harukiti82/esp32-line-tracer/setting.png

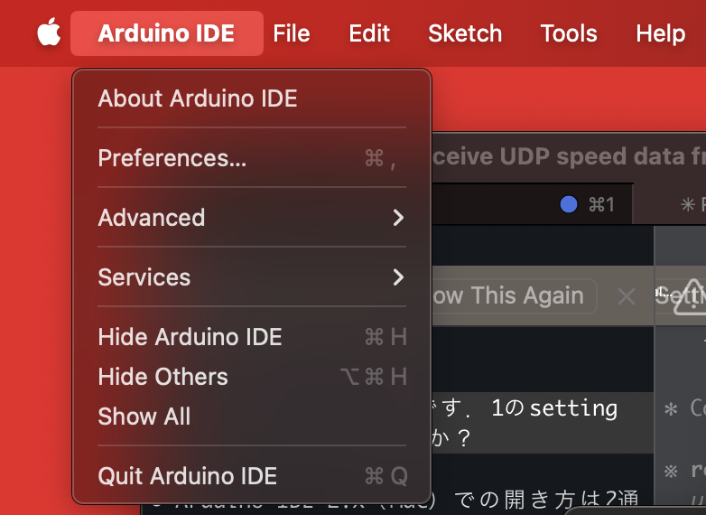
setting.png
