harukiti82/esp32-line-tracer/setting1.png

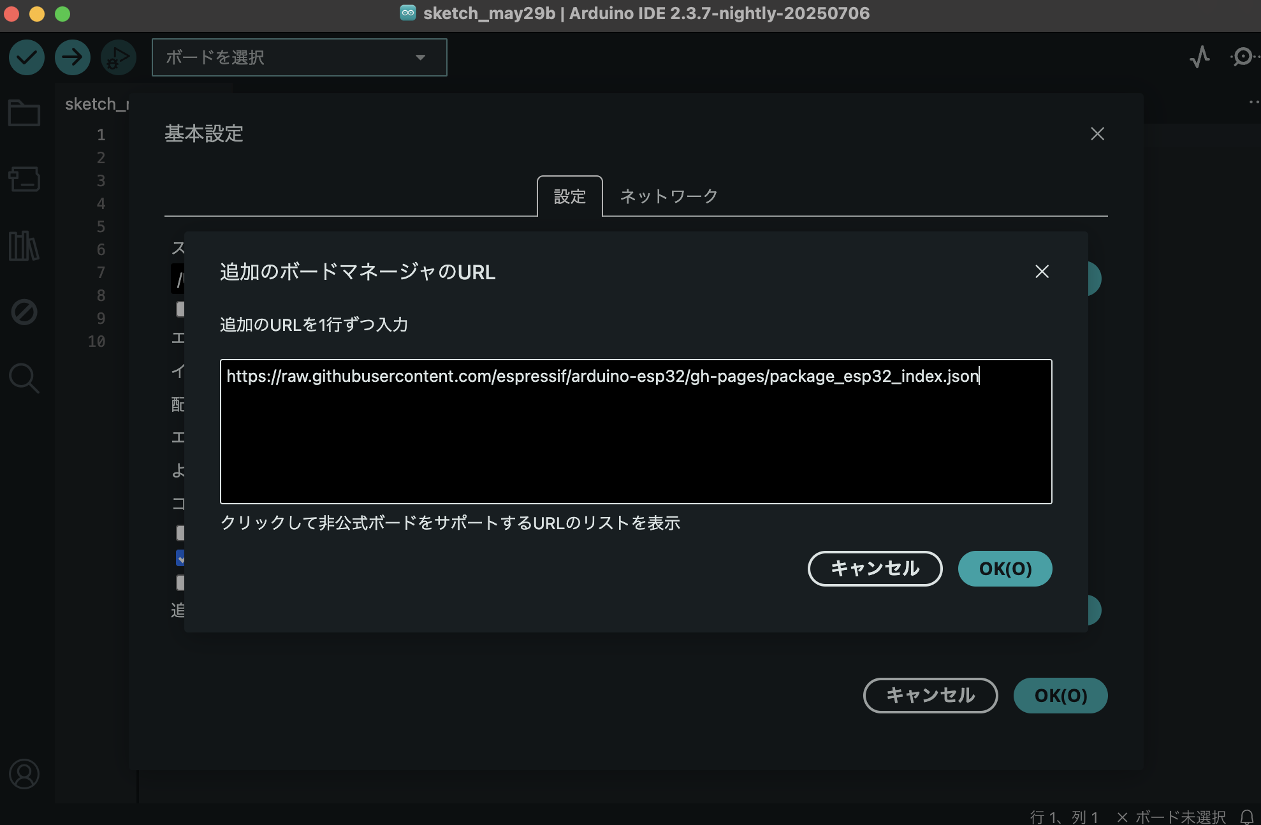
setting1.png
