harukiti82/esp32-line-tracer/course/print.html

# ライントレース用 印刷コース（A4タイル）

白地に黒線（ファームの LINE_IS_DARK = true 用）。線幅 30mm。
タイルは 180mm 角。線は各辺の中央を通るので、タイル同士を辺で突き合わせると線がつながる。

## ① 必ず原寸で印刷

印刷ダイアログで 倍率 100%（「用紙に合わせる」は OFF）、余白なし。
印刷後、下の定規が ちょうど 100mm なら原寸。ずれていたら倍率を直して再印刷。

## ② 切る

各タイルの 外周の破線（180mm 角）で切る。四隅のトンボを目印に。

## ③ つなぐ

切った辺同士をぴったり突き合わせ、裏からテープで留める（表に黒いテープを出さない）。
最小の周回コース = カーブ4枚を 2×2 に並べる（円形の輪）。直線タイルを挟めば長くできる。
タイルは正方形なので、紙を回して向きを合わせる（直線は縦横どちらにも、カーブは4方向に）。

## ④ 走らせる

床に平らに敷く（浮き・影は誤検出のもと）。シリアルに i で検出確認 → l で走行。
線を拾わない/フラつくときは、ファームの LINE_MARGIN・KP・BASE_SPEED を調整。

直線タイル（必要枚数を印刷。縦横は紙を回して使う）

90°カーブタイル（向きは紙を回して合わせる。曲線半径 90mm = やや急。低速で）
