harukiti82/esp32-line-tracer/(commit log)

2026-06-08 [機能追加] XIAO ESP32-S3 Sense ライントレース+UDPリモコン一式を初期化
    ESP32-S3 Sense でカメラのライン検出による自律走行と、Processing からの
    UDP リモコン駆動を同一経路で扱うファーム・PC側リモコン・README を追加。
2026-06-08 [修正] カメラ FB-SIZE mismatch 対策(XCLK 10MHz化+初期フレーム読み捨て)
    XIAO ESP32-S3 Sense でFPCが長く20MHzだとDMAが1フレームを取り切れず
    "FB-SIZE: 3840 != 19200" が出る。XCLKを10MHzに下げ、起動直後の
    壊れやすいフレームを5枚読み捨てて安定させる。
    [esp32_motor_udp.ino]
2026-06-08 [機能追加] ライントレースの輝度キャリブレーション(c/x, NVS永続化)
    床と線の輝度を実測して線の明暗と絶対しきい値を自動決定する2ステップ較正を
    追加。シリアル 'c' で較正・'x' で消去し、結果は Preferences(NVS) に保存して
    再起動後も保持する。未較正時は従来の適応しきい値で動く後方互換。検出ログに
    cal= 状態を表示し、README にも手順を追記。
2026-06-08 [修正] RoiStat構造体を最初の関数より前へ移動しコンパイルエラー解消
    Arduinoの自動プロトタイプ生成は最初の関数定義の直前にプロトタイプを挿入する。
    RoiStat を返す sampleRoiStat のプロトタイプが構造体定義より前に来て
    "'RoiStat' does not name a type" になっていたため、RoiStat の定義を
    LineResult と同じく最初の関数より前へ移動した。
    [esp32_motor_udp.ino]
2026-06-08 [機能追加] LINEモードの基準速度をProcessingのUDP値で可変に
    LINE走行中に "L,R" UDP を受けたら左右の平均を基準速度(g_baseSpeed)として
    採用する。操舵はカメラP制御のまま、Processingを速度ツマミとして使える。
    キープアライブ再送で値が変わったときだけ反映・表示し、テレメトリに base= を
    追加。READMEとProcessingコメントにモード別の値の意味を明記。
2026-06-08 [機能追加] 起動時オートスタート(PCなしなら数秒後にLINE自動開始)
    バッテリー単体起動を想定し、起動後 BOOT_AUTOSTART_SEC 秒(既定3秒)の
    カウントダウン中にシリアル入力が無ければ自動でLINE自律走行に入る。
    PCデバッグ時は何かキーを送ればIDLE維持。カメラNG時は走行せずIDLE。
    スイッチ操作なしで電源投入だけで走り出せる。
2026-06-08 [機能追加] モーターゲイン較正(m, 左右バランス＋中立トリム, NVS永続化)
    連続回転サーボ/ESCの個体差を補正する較正を追加。'm' でライブ調整し、
    左右ゲイン(倍率)と中立(停止us)を w/s/a/d/j/k で合わせて 'v' で保存。
    setMotorPercent でゲイン反映＋個別中立＋ESC範囲クランプを行い、LINE/REMOTE
    両モードに効く。起動時にNVSから復元。READMEに手順を追記。
2026-06-08 [修正] モーター較正の中立トリムを左右独立化(0%で停止しない不具合)
    中立トリムが左右を逆方向に同時に動かす設計で、両輪を同時に真の中立に
    合わせられず 0% でも停止しなくなっていた。j/k=左中立、n/m=右中立として
    左右を独立に調整できるようにし、各輪を個別に停止点へ合わせられるよう修正。
    READMEに復帰手順(m→r→v で1500に戻す)も追記。
    [esp32_motor_udp.ino]
2026-06-08 [修正] REMOTEリモコンの不安定を解消(カメラ無効化+UDP全吸い出し)
    REMOTE中もループ毎にカメラ取り込みを実行しており、ループ伸長/スタックで
    UDP応答が遅れフェイルセーフ誤発火でガクついていた。REMOTE時はlineTrace()を
    回さずループを軽くし、handleUdpは溜まったパケットを毎回すべて吸い出して
    最新指令を反映するよう変更(キープアライブ/連打のバックログ解消)。
    [esp32_motor_udp.ino]
2026-06-09 [機能追加] ProcessingからUDPでモード切替(l/r/i)を可能に
    シリアル接続なしでLINE/REMOTE/IDLEを切り替えられるよう、ESP32の
    UDP受信に英字1文字のモード切替コマンドを追加。LINEモードに入れば
    数値送信で巡航速度を遠隔調整できる。切替時は速度を0に中立化し、
    モードコマンドはキープアライブを汚さずREMOTEのフェイルセーフ誤発火を防ぐ。
2026-06-09 [改善] SoftAPの安定化(モデムスリープ無効化+チャンネル/接続数固定)
    省電力スリープでRFが間欠停止するとUDP取りこぼしや切断の一因になるため
    WiFi.setSleep(false)で常時ON化。チャンネルを6に固定し最大接続を1台に絞って
    2.4GHz混雑時の安定性を上げる。なお走行中の切断は外部アンテナ未接続や
    モーター電流によるブラウンアウト等のハード要因が主因のことが多い。
2026-06-10 [修正] REMOTEで50%以降頭打ちする問題(SPEED_RANGEを実機飽和点に合わせる)
    ESC/連続回転サーボは中立±250us程度で最大回転に達し、1750〜2000usが
    不感帯になっていた。SPEED_RANGEを500→250にして0〜100%を1500〜1750usへ
    線形割当し、100%まで一定の傾きで速度が上がるようにする。最高速はハード上限の
    ままで、操作レンジを実機に合わせて引き伸ばす変更。LINEの%→us変換にも効く。
    [esp32_motor_udp.ino]
2026-06-10 [修正] 飽和点の実測値に合わせSPEED_RANGEを200へ(80%以降の頭打ち解消)
    SPEED_RANGE=250では80%(=1700us)以降フラットだったため、飽和点は中立+200us
    (≈1700us)と確定。200にして0〜100%を1500〜1700usへ線形割当し、不感帯ゼロで
    100%まで速度が上がるようにする。
    [esp32_motor_udp.ino]
2026-06-10 [修正] モーター不感帯補正(低%で回り出さない問題を解消)
    静止摩擦+ESC不感帯で左15%/右20%以下では回らなかった。%→us変換に
    percentToSwing()を挟み、非ゼロ指令は最小deadUs(左30/右40us)から
    SPEED_RANGEまで線形割当して1%でも不感帯を飛び越えるようにする。
    0%は完全停止を維持。左右個体差に合わせ不感帯は別値。
    [esp32_motor_udp.ino]
2026-06-10 [改善] 上限速度を拡張(SPEED_RANGEを500=2000usフルレンジへ)
    まだ上に余力があるとの実測から、100%到達パルスを1700us→2000us(ESC前進フル)
    へ拡張。低速の出だしは不感帯補正(DEADBAND)で維持したまま上限だけ伸ばす。
    頭打ちが100%手前に出るならその%に合わせて減らして調整する。
2026-06-10 [修正] SPEED_RANGEを飽和点の250へ確定(100%=実機最高速に合わせる)
    SPEED_RANGE=500で45%飽和(≈1745us)と判明し、モーターの物理上限が中立+約245us
    であることが確定。250にして100%を飽和点(≈1750us)へ合わせ、0〜100%を線形フル活用。
    これ以上上げても最高速は上がらず上側のデッドゾーンが増えるだけ(最高速はハード上限)。
    [esp32_motor_udp.ino]
2026-06-10 [機能追加] リモコンをBPMで速度管理(speed_bpm_table.pdf準拠)
    入力単位を%からBPM(40〜240)に変更。BPM→速度[m/s]→モーター%へ変換して
    従来どおり%をUDP送信する(ESP32は無改修)。表が等間隔のためBPM↔速度は線形、
    %は100%=最高速0.33m/sを基準に線形。画面はBPM/速度/%を表示、↑↓で±5BPM、
    s/Spaceで停止。LINEモードでは送ったBPMが巡航速度になる。
2026-06-17 [修正] SoftAPに接続できない問題(最大接続数1を4へ/チャンネル1へ)
    最大接続数1だと接続枠の残留や他端末専有で2台目以降が弾かれ
    "接続できませんでした"になるため4に戻す。混雑回避でチャンネルも1へ。
    [esp32_motor_udp.ino]
2026-06-17 [機能追加] ESP-NOW通信版を追加(走行/中継/Processing、UDP版はバックアップ温存)
    SoftAP/UDPは接続確立(SSID表示・認証・DHCP)が不安定で繋がらないため、
    無線区間をコネクションレスのESP-NOWに置換。MacはESP-NOWを直接話せないので
    中継ESP32(USB接続)がシリアル↔ESP-NOWを変換する3者構成。既存の
    esp32_motor_udp/・processing_remote/ は無改変でバックアップとして残す。
2026-06-18 [改善] 高速コーナー脱線を解消(自動減速+外輪飽和補償)
    BPM180以上でコーナー脱線する原因は、高速時に外輪が100%で飽和して
    左右差(旋回の鋭さ)が潰れること、およびカーブで減速しないこと。
    誤差|norm|が大きい急カーブほどbaseを一時的に落とし、外輪が100を
    超えた分は内輪から引いて左右差2*turnを保つようにした。直線速度は維持。
2026-06-18 [修正] .gitignoreのbackup除外が効かない問題(インラインコメント除去)
    gitignoreは行末#コメント非対応で "backup/ #..." がパス名扱いになり
    無視できていなかった。コメントを別行に分離してbackup/を正しく除外する。
2026-06-18 [機能追加] 編集前バックアップをgit管理に追加(GitHub共有用)
    backup/ をリモートにも残すため.gitignoreの除外を解除し追跡対象にする。
2026-06-18 [ドキュメント] READMEをESP-NOW通信前提に書き換え
    構成図・セットアップ(走行機/中継機/Processing)・モード表・通信プロトコル・
    フェイルセーフ・制御アーキをESP-NOW中継経由に更新。旧UDP/SoftAP版は
    バックアップとして残る旨を明記。コーナー減速CORNER_SLOWDOWNも反映。
2026-06-18 [改善] Processingのシリアルポート自動選択を堅牢化(cu優先・tty除外)
    中継機接続時に /dev/tty.* を掴むと "Port busy" になりやすかった。
    Macで双方向通信に使う /dev/cu.usbmodem 系を優先し tty.*/Bluetooth を
    除外。接続失敗時はシリアルモニタを閉じる案内も表示する。
2026-06-18 [改善] 高速コーナーの蛇行をPD制御で抑制(D項KD追加)
    P制御のみだと高速時に誤差へ過剰反応してオーバーシュート→蛇行で外れる。
    誤差の変化(dNorm)に比例するD項KDを足し、行き過ぎを制動する。ライン消失中は
    微分項をリセットして再検出時の急操舵を防ぐ。READMEのチューニング項目も更新。
2026-06-18 [改善] 直線蛇行を操舵の不感帯で抑制(STEER_DEADZONE追加)
    PD制御のD項がカメラ重心ノイズを拾い、直線(誤差≈0)で蛇行が出ていた。
    中央付近(|正規化誤差|<STEER_DEADZONE)は直進扱いにして操舵0にする。
    norm=0でP項・D項・コーナー減速がすべて無効化され、直線は真っ直ぐ最速で
    走れる(直線速度は犠牲にしない)。カーブは誤差が大きく不感帯外なので無影響。
2026-06-18 [修正] デッドバンドでコーナー消失停止する問題(ソフト化+0.05へ縮小)
    ハードに norm=0 でクリップしたため、カーブ入口の小さな誤差を無視→反応が
    遅れて曲がりきれずライン消失で停止していた。不感帯分を差し引いて滑らかに
    操舵を立ち上げるソフト不感帯にし、幅も0.08→0.05へ縮小。中央付近は引き続き
    操舵0で直線蛇行は抑えたまま、カーブ入口の手遅れを解消する。
    [esp32_motor_espnow_20260618_before_softdz.ino]
2026-06-18 [改善] 直線蛇行の根本対策に重心ローパスフィルタを追加(NORM_FILT_A)
    不感帯(±0.05)でも直線蛇行が消えないのは、カメラ重心ノイズの振幅が不感帯を
    超えてバタついているため。誤差に指数移動平均(係数0.5)を掛けてノイズ源を
    平滑化し、P項・D項の震えを根本から抑える。消失時はフィルタ状態もリセット。
    軽めの係数でカーブの反応遅れ(消失方向)を最小限にする。
2026-06-22 [ドキュメント] ライントレースの仕組みを高校生向けに解説したmdを追加
2026-06-22 [リファクタ] 未使用のキャリブレーション機能を撤去(較正版はバックアップ保持)
    床/線輝度の自動較正(c/x)と左右モーターゲイン較正(m)を削除。しきい値は
    帯平均±LINE_MARGINの適応式に一本化し、ゲイン・中立は定数固定にした。
    Preferences依存も除去。撤去前のコードは backup/ に退避。READMEも同期。
2026-06-24 [改善] 影・外光に強いローカル適応しきい値に変更
    画面全体で1つの絶対しきい値だと、影や外光で片側だけ明るさが偏ると誤検出/
    消失していた。各画素を横方向の局所平均±LINE_MARGINと比べる方式にし、緩やかな
    明るさムラを背景ごと打ち消す。局所平均はrunning sumで行ごとO(W)。LOCAL_BG_R追加。
2026-06-24 [改善] 較正機能を復活させ外光対策(ローカル適応しきい値)と両立
    メイン制御を0622較正版に戻しつつ、外光改善を統合。検出は較正の有無に関わらず
    各画素を周囲の局所平均±マージンと比べるローカル適応式にし、影や外光の明るさムラを
    背景ごと打ち消す。較正は絶対しきい値ではなく「明暗方向＋実測した床/線の輝度差(半分)を
    マージン」として供給する形に読み替え、c/x/mを活かしたまま外光耐性を得る。
2026-06-24 [改善] 240BPM高速コーナーの脱線をコーナー速度上限で抑制
    比例減速(CORNER_SLOWDOWN)だけだと誤差が最大化するまで十分減速せず反応が遅れ、
    240BPM等の高速で曲がりきれず脱線していた。CORNER_SLOWDOWNを0.6→0.8に上げ、
    コーナー検知(|正規化誤差|>CORNER_CAP_AERR)で即CORNER_MAX_SPEED(38%)に頭打ち。
    直線(g_baseSpeed)はいくら速くしてもカーブだけ安全速度に落ちる。直線速度は不変。
2026-06-24 [修正] 急カーブで失速停止する回帰を速度下限で修正+ROI先読み併用
    前回のコーナー減速(CORNER_SLOWDOWN 0.8+上限38の即頭打ち)が強すぎ、急カーブで
    baseが落ちすぎて失速・急ピボットでライン消失して止まっていた。CORNER_SLOWDOWNを
    0.5に緩め、CORNER_MIN_SPEED(24%)の下限を追加してコーナー速度を上限〜下限で挟む。
    併せてROIを上げ(0.65-0.95→0.48-0.80)、約1車身先のカーブを早く捉えて反応時間を稼ぐ。
    [esp32_motor_espnow.ino]
2026-06-24 [修正] 240BPM急カーブのライン消失停止を修正(ROI広帯+生誤差で即減速)
    停止はモーター停止でなくライン消失(px<MIN_LINE_PIX)。前回ROIを0.48-0.80へ帯ごと
    上にずらし手前(画面下)を捨てたため、急カーブで線が最初に来る手前を見失い消失停止
    していた。ROIを0.50-0.95の広帯に直し近接保持と先読みを両立(下端は画面下に残す)。
    さらにコーナー減速をローパス後のaerrでなく生の|rawNorm|併用にし、入口の突っ込みを防ぐ。
    [esp32_motor_espnow.ino]
2026-06-24 [改善] 直線安定化: 車体の傾き(ヘディング)項を追加
    実機で正常動作した純正0622(較正版)にアクティブを戻し、その上に直線安定化を追加。
    途中の外光対策(ローカル適応)・コーナー速度上限/ROI変更は破棄(git履歴に保持)。
    カーブ直後に車体が斜めでも横位置が中央だと従来は直進扱いになり、ズレてから直す
    繰り返しでふらついた。ROIを手前帯/先帯に分け、両重心の差(画像内の線の傾き=車体の
    傾き)をK_ANGLEで操舵に加算。ズレる前に自己整列して直線のふらつきを抑える。横位置の
    PD制御は不変、両帯に十分な画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
2026-07-05 [改善] Processingのブリッジポートを固定しtest_base同時接続時の誤選択を防止
    荷重センサArduino(test_base)を同時にMacへ挿す運用に備え、BRIDGE_PORTを
    ブリッジESP32の実ポートに固定。空文字時の"末尾自動選択"だと後挿しの
    test_base側を掴む恐れがあった。合わせて未コミットで残っていた自動選択
    ロジックの簡素化分も同梱(固定後は当該ブロックは不実行)。
2026-07-05 [ドキュメント] Mac1台で走行操作とtest_base監視を同時に使う手順を追加
    車を走らせながら荷重センサ側(test_base)のBPM判定ログを同時に見る運用手順。
    ポートが競合しない理由・ツール3択(screen/Arduino IDE/CoolTerm)・
    トラブルシューティングを記載。
2026-07-06 [ドキュメント] 発表スライド用のライントレース仕組み解説を追加
    Marp対応・1スライド1論点・発表者用の話す台本つき。既存の読み物解説とは別に、
    そのまま口頭発表できる構成で新規作成。
2026-07-08 [修正] 左モーター接触不良の配線入替に合わせてピン定数をD0↔D1で交換
    D0(GPIO1)側の接点接触不良で左モーターが弱っていた。配線をD0↔D1で入れ替えて
    復旧したため、実機で動く配線を正としてMOTOR_L_PIN/MOTOR_R_PINを交換。
    左右の較正(INVERT/ゲイン/不感帯)はservoL/servoRに紐づくため整合は保たれ、
    LINEモードの操舵反転も起きない。
    [esp32_motor_espnow.ino]
